M4rxz4n/EE542-RehabSense/README.md

# EE542-RehabSense
Rehab Sense Project for embedded systems capstone class
