M4rxz4n/EE542-RehabSense/final/schematics/rehabsense-second/rehabsense-second/rehabsense-second.kicad_pcb

## KiCad design final/schematics/rehabsense-second/rehabsense-second/rehabsense-second.kicad_pcb (2026-11-13)

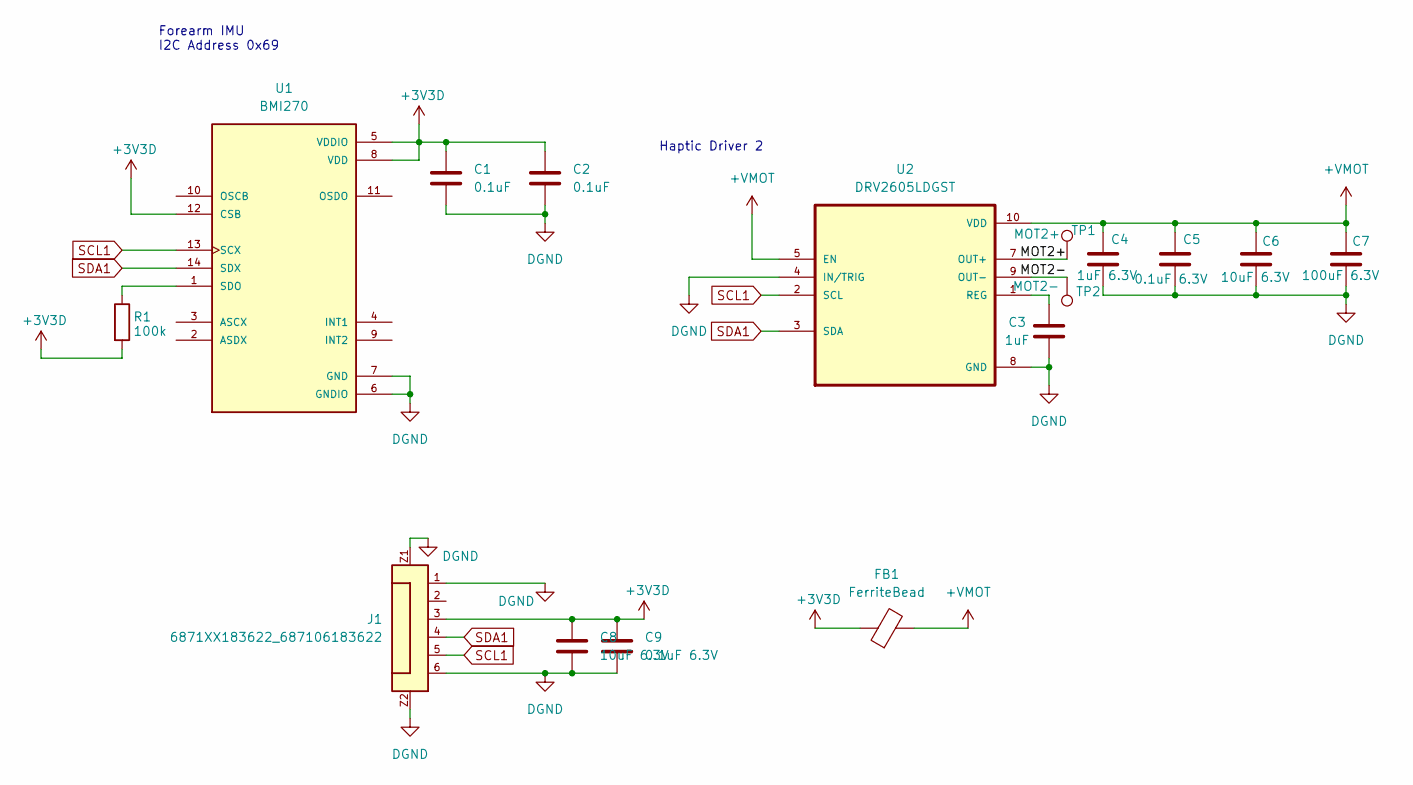
[picture p1: schematic rehabsense-second.kicad_sch]

Parts:
C1, C2: 0.1uF; C_0603_1608Metric
C3: 1uF; C_0603_1608Metric
C4: 1uF 6.3V; C_0603_1608Metric
C5, C9: 0.1uF 6.3V; C_0603_1608Metric
C6: 10uF 6.3V; C_1206_3216Metric
C7: 100uF 6.3V; C_1206_3216Metric
C8: 10uF 6.3V; C_0603_1608Metric
FB1: FerriteBead; L_0603_1608Metric
J1: 6871XX183622_687106183622; 687106183622; MPN 687106183622
R1: 100k; R_0603_1608Metric
TP1: MOT2+; Pin_D1.1mm_L8.5mm_W2.5mm_FlatFork
TP2: MOT2-; Pin_D1.1mm_L8.5mm_W2.5mm_FlatFork
U1: BMI270; XDCR_BMI270
U2: DRV2605LDGST; SOP50P490X110-10N

Connections:
+3V3D: C1.1, C2.1, C8.1, C9.1, FB1.1, J1.3, R1.2, U1.5 (VDDIO), U1.8 (VDD), U1.12 (CSB); also elsewhere on the board
+VMOT: C4.1, C5.1, C6.1, C7.1, FB1.2, U2.5 (EN), U2.10 (VDD)
/MOT2+: TP1.1 (1_1), U2.7 (OUT+)
/MOT2-: TP2.1 (1_1), U2.9 (OUT-)
DGND: C1.2, C2.2, C3.2, C4.2, C5.2, C6.2, C7.2, C8.2, C9.2, J1.1, J1.6, J1.Z1, J1.Z2, U1.6 (GNDIO), U1.7 (GND), U2.4 (IN/TRIG), U2.8 (GND); also elsewhere on the board
unnamed: R1.1, U1.1 (SDO)
unnamed: C3.1, U2.1 (REG)
SCL1: J1.5, U1.13 (SCX), U2.2 (SCL); also elsewhere on the board
SDA1: J1.4, U1.14 (SDX), U2.3 (SDA); also elsewhere on the board

Notes on the sheet:
Haptic Driver 2
Forearm IMU I2C Address 0x69

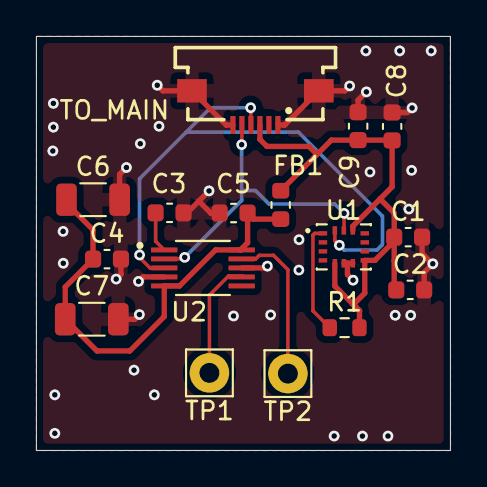
[picture p2: board rehabsense-second.kicad_pcb from above]

Board: 2 copper layers, 23.0 x 23.0 mm, 16 parts (0 on the bottom side), 9 nets.

Other parts of the board:
TO_MAIN: 6871XX183622_687106183622; 687106183622

Their connections:
+3V3D: TO_MAIN.3; also elsewhere on the board
DGND: TO_MAIN.1, TO_MAIN.6, TO_MAIN.Z1, TO_MAIN.Z2; also elsewhere on the board
SCL1: TO_MAIN.5; also elsewhere on the board
SDA1: TO_MAIN.4; also elsewhere on the board
