M4rxz4n/EE542-RehabSense/final/schematics/rehabsense-main/rehabsense-main.kicad_pcb

## KiCad design final/schematics/rehabsense-main/rehabsense-main.kicad_pcb (2026-11-13)

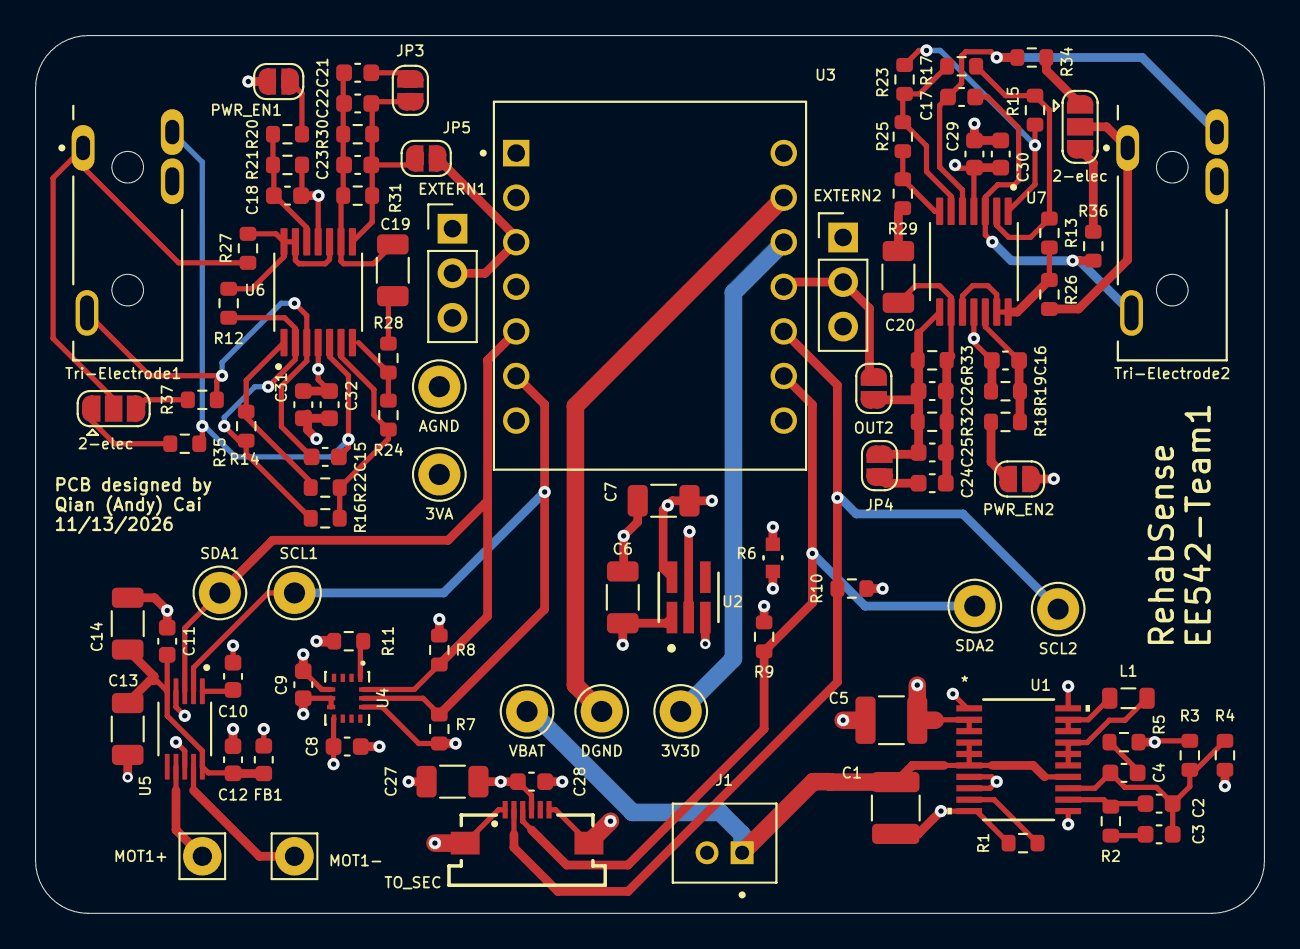
[picture p3: board rehabsense-main.kicad_pcb from above]

Board: 4 copper layers, 70.0 x 50.0 mm, 103 parts (0 on the bottom side), 55 nets.

Parts:
2-elec, 2-elec#2: SolderJumper_3_Open; SolderJumper-3_P1.3mm_Open_RoundedPad1.0x1.5mm
3V3D, 3VA: TestPoint; Pin_D1.0mm_L10.0mm_LooseFit
AGND: TestPoint; Pin_D1.0mm_L10.0mm_LooseFit
C1: 47uF 10V; C_1210_3225Metric
C2: 12pF; C_0603_1608Metric
C3: 680pF; C_0603_1608Metric
C4: 47pF; C_0603_1608Metric
C5: 100uF 6.3V; C_1210_3225Metric
C6, C7: 1uF 10V; C_1206_3216Metric
C8, C9: 0.1uF; C_0603_1608Metric
C10: 1uF; C_0603_1608Metric
C11: 1uF 6.3V; C_0603_1608Metric
C12, C28: 0.1uF 6.3V; C_0603_1608Metric
C13, C27: 10uF 6.3V; C_1206_3216Metric
C14: 100uF 6.3V; C_1206_3216Metric
C15, C17: 2.2nF; C_0603_1608Metric
C16, C18: 220nF; C_0603_1608Metric
C19, C20: 47uF; C_1206_3216Metric
C21, C23, C24, C26: 47nF; C_0603_1608Metric
C22, C25: BPFC_C; C_0603_1608Metric
C29, C31: 100nF; C_0603_1608Metric
C30, C32: 4.7uF; C_0603_1608Metric
DGND: TestPoint; Pin_D1.0mm_L10.0mm_LooseFit
EXTERN1, EXTERN2: Conn_01x03_Pin; PinHeader_1x03_P2.54mm_Vertical
FB1: FerriteBead; L_0603_1608Metric
J1: B2B-PH-K-S; JST_B2B-PH-K-S
JP3, JP4, JP5: SolderJumper_2_Open; SolderJumper-2_P1.3mm_Open_RoundedPad1.0x1.5mm
L1: 2.2uH; L_0805_2012Metric
MOT1+: MOT1+; Pin_D1.1mm_L8.5mm_W2.5mm_FlatFork
MOT1-: MOT1-; Pin_D1.1mm_L8.5mm_W2.5mm_FlatFork
OUT2: SolderJumper_2_Open; SolderJumper-2_P1.3mm_Open_RoundedPad1.0x1.5mm
PWR_EN1, PWR_EN2: SolderJumper_2_Open; SolderJumper-2_P1.3mm_Open_RoundedPad1.0x1.5mm
R1: 90.9k; R_0603_1608Metric
R2: 49.9k; R_0603_1608Metric
R3: 825k; R_0603_1608Metric
R4: 182k; R_0603_1608Metric
R5: 6.49k; R_0603_1608Metric
R6: 0R; RC0603N_YAG
R7, R8, R9, R10: 2.2k; R_0603_1608Metric
R11: 100k; R_0603_1608Metric
R12, R13, R18, R19, R20, R21, R24, R25: 10k; R_0603_1608Metric
R14, R15, R22, R23, R26, R27, R28, R29: 1k; R_0603_1608Metric
R16, R17: RG; R_0603_1608Metric
R30, R32: BPFC_R; R_0603_1608Metric
R31, R33, R34, R35, R36, R37: 1M; R_0603_1608Metric
SCL1, SCL2: TestPoint; Pin_D1.0mm_L10.0mm_LooseFit
SDA1, SDA2: TestPoint; Pin_D1.0mm_L10.0mm_LooseFit
TO_SEC: 6871XX183622_687106183622; 687106183622
Tri-Electrode1, Tri-Electrode2: SJ3-35083C-TR; SAMESKY_SJ3-35083C-TR
U1: LTC3113EFE-TRPBF; TSSOP-20_FE&slash_CA_LIT
U2: TPS7A2030PDBVR; DBV0005A-IPC_A
U3: XIAO_ESP32_S3; MODULE_XIAO_ESP32_S3
U4: BMI270; XDCR_BMI270
U5: DRV2605LDGST; SOP50P490X110-10N
U6, U7: OPA4322AIPWR; SOP65P640X120-14N
VBAT: TestPoint; Pin_D1.0mm_L10.0mm_LooseFit

Connections:
+3V3D: 3V3D.1 (1_1), C5.1, C6.1, C8.1, C9.1, C27.1, C28.1, FB1.1, R3.2, R5.2, R7.1, R8.1, R9.1, R10.1, TO_SEC.4, U1.2 (VOUT), U1.3 (VOUT), U2.1 (IN), U2.3 (EN), U3.12 (3V3), U4.5 (VDDIO), U4.8 (VDD), U4.12 (CSB)
+3VA: 3VA.1 (1_1), C7.1, C29.2, C30.2, C31.2, C32.2, EXTERN1.1, EXTERN2.1, PWR_EN1.2 (B), PWR_EN2.2 (B), U2.5 (OUT), U6.4, U7.4
+BATT: C1.1, J1.1, U1.4 (VIN), U1.5 (VIN), U1.6 (VIN), U1.14 (RUN), VBAT.1 (1_1)
+VMOT: C11.1, C12.1, C13.1, C14.1, FB1.2, U5.5 (EN), U5.10 (VDD)
/emg/OUT1: C22.2, C23.2, JP3.1 (A), JP5.2 (B), R30.2, R31.2, U6.8
/emg/OUT2: C25.2, C26.2, JP4.1 (A), OUT2.2 (B), R32.2, R33.2, U7.8
/emg/ampref1: R12.1, R27.1, U6.10, U6.13, U6.14
/emg/ampref2: R13.1, R26.1, U7.10, U7.13, U7.14
/emg/bpfIN1: C19.2, C21.1, C22.1, C23.1, R30.1, R31.1, U6.9
/emg/bpfIN2: C20.2, C24.1, C25.1, C26.1, R32.1, R33.1, U7.9
/emg/inaOUT1: R24.2, R28.1, U6.7
/emg/inaOUT2: R25.2, R29.1, U7.7
/haptic/MOT1+: MOT1+.1 (1_1), U5.7 (OUT+)
/haptic/MOT1-: MOT1-.1 (1_1), U5.9 (OUT-)
ADC1: EXTERN1.2, JP5.1 (A), U3.3 (D2/GPIO3)
ADC2: EXTERN2.2, OUT2.1 (A), U3.11 (D10/GPIO9)
AGND: AGND.1 (1_1), C6.2, C7.2, C16.1, C18.1, C29.1, C30.1, C31.1, C32.1, EXTERN1.3, EXTERN2.3, R6.2, R19.1, R21.1, U2.2 (GND), U6.11, U7.11
DGND: C1.2, C5.2, C8.2, C9.2, C10.2, C11.2, C12.2, C13.2, C14.2, C27.2, C28.2, DGND.1 (1_1), J1.2, R1.1, R4.1, R6.1, R11.2, TO_SEC.1, TO_SEC.6, TO_SEC.Z1, TO_SEC.Z2, U1.1 (PGND), U1.7 (SGND), U1.8 (BURST), U1.10 (PGND), U1.11 (PGND), U1.20 (PGND), U3.13 (GND), U4.6 (GNDIO), U4.7 (GND), U5.4 (IN/TRIG), U5.8 (GND)
DRL1: 2-elec.2 (C), R27.2, Tri-Electrode1.1
DRL2: 2-elec#2.2 (C), R26.2, Tri-Electrode2.1
IN1+: C15.1, R37.2, Tri-Electrode1.2, U6.3
IN1-: C15.2, R35.1, Tri-Electrode1.4, U6.5
IN2+: C17.1, R36.2, Tri-Electrode2.2, U7.3
IN2-: C17.2, R34.1, Tri-Electrode2.4, U7.5
unnamed: C3.1, R2.2
unnamed: C4.2, R5.1
unnamed: C16.2, R18.1, R19.2, U7.12
unnamed: C18.2, R20.1, R21.2, U6.12
unnamed: C19.1, R28.2
unnamed: C20.1, R29.2
unnamed: PWR_EN2.1 (A), R18.2
unnamed: PWR_EN1.1 (A), R20.2
unnamed: C21.2, JP3.2 (B)
unnamed: C24.2, JP4.2 (B)
unnamed: 2-elec#2.1 (A), R34.2
unnamed: 2-elec#2.3 (B), R36.1
unnamed: 2-elec.1 (A), R35.2
unnamed: 2-elec.3 (B), R37.1
unnamed: L1.1, U1.18 (SW2), U1.19 (SW2)
unnamed: L1.2, U1.15 (SW1), U1.16 (SW1), U1.17 (SW1)
unnamed: R12.2, R14.1, R16.1, U6.2
unnamed: R13.2, R15.1, R17.1, U7.2
unnamed: R14.2, R22.1, U6.1
unnamed: R15.2, R23.1, U7.1
unnamed: R16.2, R22.2, R24.1, U6.6
unnamed: R17.2, R23.2, R25.1, U7.6
unnamed: C2.2, C3.2, C4.1, R3.1, R4.2, U1.13 (FB)
unnamed: R1.2, U1.9 (RT)
unnamed: C2.1, R2.1, U1.12 (VC)
unnamed: R11.1, U4.1 (SDO)
unnamed: C10.1, U5.1 (REG)
SCL0: R7.2, SCL1.1 (1_1), U3.6 (D5/GPIO6), U4.13 (SCX), U5.2 (SCL)
SCL1: R10.2, SCL2.1 (1_1), TO_SEC.2, U3.10 (D9/GPIO8)
SDA0: R8.2, SDA1.1 (1_1), U3.5 (D4/GPIO5), U4.14 (SDX), U5.3 (SDA)
SDA1: R9.2, SDA2.1 (1_1), TO_SEC.3, U3.9 (D8/GPIO7)
