M4rxz4n/EE542-RehabSense/(commit log)

2026-10-13 added subsheets
    [haptic.kicad_sch, imu.kicad_sch, mcu.kicad_sch, power.kicad_sch, rehabsense-main.kicad_sch]
2026-10-16 Adding schematics
    [emg.kicad_sch, haptic.kicad_sch, imu.kicad_sch, mcu.kicad_sch, rehabsense-main.kicad_sch]
2026-10-16 small changes
    [emg.kicad_sch, mcu.kicad_sch]
2026-10-22 Add prototype firmware for ESP32-S3-DevKitC-1
    [partitions.csv]
2026-10-23 Adding adcs
    [adc.kicad_sch, emg.kicad_sch, power.kicad_sch, rehabsense-main.kicad_sch]
2026-10-23 adding more circuits
    [adc.kicad_sch, imu.kicad_sch, mcu.kicad_sch]
2026-10-24 Add Wi-Fi bulk transfer, full session record, fix live-stream bugs
    [main.c, rehab_config.h]
2026-10-24 Reorganise into prototype/ and final/
    [adc.kicad_sch, emg.kicad_sch, haptic.kicad_sch, imu.kicad_sch, mcu.kicad_sch, partitions.csv, power.kicad_sch, rehabsense-main.kicad_pcb]
2026-10-27 fixing issues
    [adc.kicad_sch, emg.kicad_sch, haptic.kicad_sch, imu.kicad_sch, mcu.kicad_sch, power.kicad_sch, rehabsense-main.kicad_pcb]
2026-10-28 fixed layout
    [rehabsense-main.kicad_pcb]
2026-10-28 Flutter host: protocol port, BLE layer, patient view, calibration, bridge, fetch
2026-10-29 fixed jumper connection
    [haptic.kicad_sch, mcu.kicad_sch]
2026-11-02 change back to SPI 261101
2026-11-04 fixing stuff
    [adc.kicad_sch, emg.kicad_sch, haptic.kicad_sch, imu.kicad_sch, mcu.kicad_sch, power.kicad_sch]
2026-11-06 commenting out ADC
    [emg.kicad_sch, mcu.kicad_sch, power.kicad_sch, rehabsense-main.kicad_pcb, rehabsense-main.kicad_sch]
2026-11-10 Final version
    [emg.kicad_sch, haptic.kicad_sch, imu.kicad_sch, mcu.kicad_sch, power.kicad_sch, rehabsense-main.kicad_pcb]
2026-11-10 added second board
    [adc.kicad_sch, emg.kicad_sch, haptic.kicad_sch, imu.kicad_sch, mcu.kicad_sch, power.kicad_sch, rehabsense-main.kicad_pcb, rehabsense-main.kicad_sch]
2026-11-11 working on layout
    [emg.kicad_sch, haptic.kicad_sch, imu.kicad_sch, mcu.kicad_sch, rehabsense-main.kicad_pcb]
2026-11-12 rehabsense-second: routing in progress, ground fill
    [rehabsense-second.kicad_pcb]
2026-11-12 half done layout
    [emg.kicad_sch, haptic.kicad_sch, imu.kicad_sch, mcu.kicad_sch, power.kicad_sch, rehabsense-main.kicad_pcb]
2026-11-12 rehabsense-second: routing complete, motor pads on board edge, DRC clean
    [rehabsense-second.kicad_pcb]
2026-11-12 more edit
    [rehabsense-main.kicad_pcb]
2026-11-12 adding more wires
    [rehabsense-main.kicad_pcb]
2026-11-12 more wiring
    [rehabsense-main.kicad_pcb]
2026-11-13 rehabsense-second: compacted J1/FB1, 45° traces, DRC clean
    [rehabsense-second.kicad_pcb]
2026-11-13 rehabsense-second: 23 x 23
    [rehabsense-second.kicad_pcb]
2026-11-13 rehabsense-second: TA feedback - C8/C9 decaps, star 3V3, front GND pour + stitching, silkscreen, gerber files
    [rehabsense-second-B_Cu.gbr, rehabsense-second-B_Mask.gbr, rehabsense-second-B_Paste.gbr, rehabsense-second-B_Silkscreen.gbr, rehabsense-second-Edge_Cuts.gbr, rehabsense-second-F_Cu.gbr, rehabsense-second-F_Mask.gbr, rehabsense-second-F_Paste.gbr]
